akenuLegend/DroneV2/main/gitcode.odt

### Bước 1: Cập nhật tình hình (Pull)

Trước khi bạn định sửa gì, hãy lấy code mới nhất mà đồng đội đã đưa lên về máy mình:

- Chuyển về nhánh chính: git checkout main
- Kéo code mới nhất: git pull origin main

### Bước 2: Tạo "vùng an toàn" (Branch)

Đừng bao giờ sửa code trực tiếp trên nhánh main. Hãy tạo một nhánh riêng cho mình:

- git checkout -b feature-ten-cua-bạn / git checkout branch_cua_minh
- git merge main
  (Lệnh này giúp bạn vừa tạo nhánh mới, vừa nhảy sang nhánh đó luôn).

### Bước 3: Code và Lưu (Add & Commit)

Sau khi bạn đã code xong xuôi một tính năng hoặc sửa xong lỗi:

1. Gom các file đã sửa: git add .
2. Dán nhãn cho những thay đổi đó: git commit -m "Mô tả việc bạn vừa làm"
  *(Ví dụ: git commit -m "Sửa lỗi hiển thị nút bấm") *

### Bước 4: Đưa lên GitHub (Push)

Bây giờ bạn đẩy cái nhánh riêng của mình lên Repo chung trên GitHub:

- git push origin feature-ten-cua-bạn

### Bước 5: Xin phép gộp code (Pull Request - PR)

Bước này làm trên giao diện web GitHub:

1. Vào link Repo của nhóm.
2. Bạn sẽ thấy nút màu xanh "Compare & pull request" hiện lên, hãy nhấn vào đó.
3. Viết vài dòng mô tả (nếu cần) và nhấn "Create pull request".
4. Bây giờ chỉ cần chờ "Chủ xị" (Leader) vào nhấn nút Merge là code của bạn sẽ chính thức nằm trong nhánh main.

### Tóm tắt bộ lệnh "Thần chú" cho bạn:

Hành động | Lệnh Git
Cập nhật code mới nhất | git pull origin main
Tạo và sang nhánh mới | git checkout -b [tên_nhánh]
Lưu code đã sửa | git add . sau đó git commit -m "nhắn gửi"
Đẩy code lên GitHub | git push origin [tên_nhánh]

Lưu ý cực kỳ quan trọng: Nếu bạn gõ git push mà bị báo lỗi, khả năng cao là bạn chưa nhấn "Accept Invitation" trong email mời tham gia Collaborator mà bạn mình gửi đâu. Check mail ngay nếu bị kẹt nhé!

Bạn đã sẵn sàng tạo nhánh đầu tiên chưa? Thử đặt tên nhánh là dev-nguyen-anh-tuan xem sao!

Cách clone về:

git clone <đường-dẫn-vừa-copy>
