akenuLegend/DroneV2/main/sodo.png

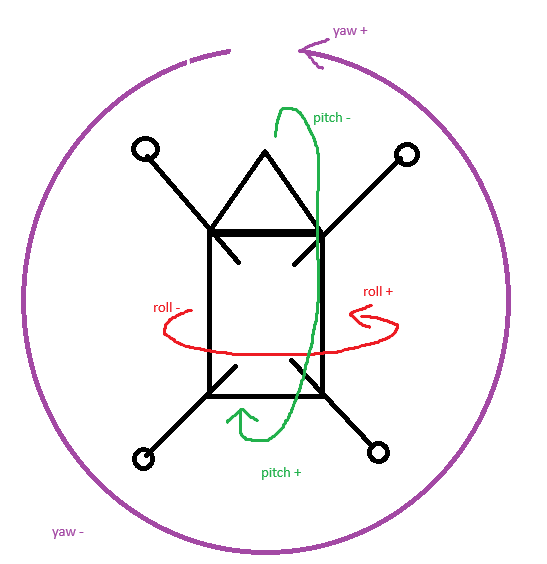
main/sodo.png
