akenuLegend/DroneV2/testZone/drone_alt_hold_1m/docs/PARAMETER_HANDBOOK.md

# Parameter handbook — configuration `0xA41F1001`

## 1. How to use this handbook

This handbook describes the authoritative current values in
`drone_alt_hold_1m.ino` (`FC`) and `sender_1m/sender_1m.ino` (`TX`). Line
locations are approximate and the symbol name is authoritative. Values are
software configuration, not proof of installed-airframe suitability.

Every row provides the requested fields. The section and “Subsystem / meaning”
column identify the subsystem. “Increase / high” and “Decrease / low” combine
directional effect with symptoms when excessive. “Safe direction / step” is a
test recommendation, not permission to fly. “Hold” means there is no evidence-
based numeric change; first collect the named observations using
`TEST_PLAN.md`. Change one parameter family at a time, assign a new config
signature, and retain an old/new/unit/reason/risk/rollback ledger.

Telemetry names below refer either to the sender `STATUS` subset or to fields
carried by telemetry v5. The current sender prints `cfg`, mode/phase/reason,
`z/sp/vz/src/corr`, altitude velocity setpoint/integral, pitch/roll, motor and
hover values, flow/position values, ages/quality/strength, loop/dt/overruns and
MTF/BMP/task diagnostics. The packet also carries yaw/rates, controller outputs,
attitude I terms, biases, vibration/clip and radio counters, but `STATUS` does
not print them. Any row that needs those fields requires a traceable packet
decoder or diagnostic build as a prerequisite. The 248-byte packet itself does
not expose raw sensor innovations, per-axis saturation causes, battery, RPM, or
stack margin; those observations are explicitly marked unavailable.

## 2. Motors and ESC

| Parameter (current value) | Unit; source / location | Subsystem / meaning | Increase / symptoms too high | Decrease / symptoms too low | Safe direction / recommended step | Observe |
|---|---|---|---|---|---|---|
| `IDLE_THROTTLE=1000` | us; FC `:115` | ESC idle/disarmed command and final ramp endpoint. | Can spin motors while nominally safe and reduce shutdown margin. | Below valid ESC pulse may stop arming or be interpreted unpredictably. | Hold; verify against ESC documentation props-off. Do not tune in flight. | Four motors, mode/phase, oscilloscope/logic analyzer (external). |
| `MOTOR_MIN_US=1050` | us; FC `:119` | Minimum armed/mixed command and touchdown intermediate floor. | More residual thrust, bounce, heat, and reduced downward authority. | Motor desync/stall and loss of attitude authority. | Establish the lowest reliable synchronized speed on a guarded rig; if needed change by at most 5 us per build. | M1--M4, throttle, phase; RPM/current are unavailable. |
| `ESC_MIN_US/ESC_MAX_US=1000/2000` | us; FC `:43` | Absolute LEDC conversion range and hardware endpoint assumptions. | Wider upper endpoint can overdrive an ESC/motor if calibration differs. | Narrower range removes available authority. | Hold unless ESC calibration is measured; change only with props removed/guarded stand. | PWM pulse measurement, M1--M4; thrust/current external. |
| `ESC_PIN_M1=26`, `ESC_PIN_M2=13`, `ESC_PIN_M3=14`, `ESC_PIN_M4=27`; `ESC_CH_M1=0`, `ESC_CH_M2=1`, `ESC_CH_M3=2`, `ESC_CH_M4=3` | GPIO, LEDC channel; FC `:40-41` | Physical FL/FR/BR/BL output mapping and single-writer LEDC channel assignment. | Not numeric tuning; any wrong pin/channel moves the wrong motor. | Same. | Mandatory props-off continuity/order/direction test; change only to match verified wiring. | One output at a time, physical motor label/direction and logic-analyzer pulse. |
| `HOVER_DEFAULT=1430` | us; FC `:118` | Boot vertical feed-forward. It is only a plausible estimate between observed lift near 1400 and strong climb near 1500. | Persistent climb/negative PI, early lift, less upper correction headroom. | Persistent sink/positive PI, delayed/no lift, saturation. | After motor/estimator validation use `HOVER n` while DISARMED; steps <=5 us, one short restrained segment each. | `hover`, `hoverTarget`, throttle, `z/vz`, `corr`, `ALTCTL I`, motors. |
| `HOVER_MIN_ALLOWED/HOVER_MAX_ALLOWED=1050/1750` | us; FC `:120-121` | Validation bounds for the RAM hover command. | Raising upper bound permits hazardous feed-forward and shrinks mixer room. | Raising lower bound can prevent a valid light-frame value; lowering permits non-hover values. | Hold; these are safety validation bounds, not tuning targets. | Command rejection, hover fields, motors. |
| `HOVER_SLEW_US_PER_S=100` | us/s; FC `:125` | Slews a hover-setting change accepted while DISARMED; the slew continues on subsequent control ticks. | Faster application can step collective after configuration changes. | Slower application delays convergence and confounds short tests. | Hold; wait for `hover==hoverTarget` before ARM. If measured response requires change, <=10% per props-off/restrained build. | `hover/hoverTarget`, throttle, `dt`. |
| Sender local `hoverUs=1400` | us; TX `:94` | Initial command-payload placeholder; it does not change the drone's `HOVER_DEFAULT=1430` on boot or heartbeat. An explicit valid `HOVER n`/`5 n` replaces it before `CMD_SET_HOVER`. | Not a flight gain until explicitly sent; a larger sent value raises feed-forward. | A smaller sent value lowers feed-forward. | Always issue and verify an explicit intended value while DISARMED; do not infer the drone value from this TX initializer. | Drone `hover/hoverTarget`, command acknowledgement and config identity. |
| `ESC_PWM_HZ=200`, `ESC_PWM_BITS=16` | Hz, bits; FC `:42` | LEDC carrier and duty resolution. Physical updates occur on PWM boundaries. | Higher rate may violate ESC protocol/timing; resolution tradeoff changes. | Lower rate adds command latency/ripple. | Hold until ESC documentation and pulse capture support a change; never tune by flight feel alone. | Logic analyzer; command loop/dt; RPM external. |
| `TRIM_M1/TRIM_M2/TRIM_M3/TRIM_M4=0/0/0/0` | us; FC trim constants | Static per-motor PWM offsets after mixing. | Positive trim creates persistent corner thrust and saturation. | Negative trim creates weak corner/desync risk. | Hold at zero; use measured thrust matching only, not CG compensation. | M1--M4, pitch/roll, controller outputs; thrust/RPM external. |
| `THRUST_EXPO=0.0` | ratio; FC `:323` | Disables inverse quadratic thrust linearization. | More compensation can improve linearity only with a measured curve; wrong expo distorts collective/authority. | Toward zero restores direct PWM behavior but leaves plant nonlinearity. | Hold until all four thrust curves are measured; then fit, replay, and introduce <=0.05 per build. | Requested/applied motors; thrust/current/RPM external and currently absent. |

## 3. Mixer and actuator authority

| Parameter (current value) | Unit; source / location | Subsystem / meaning | Increase / symptoms too high | Decrease / symptoms too low | Safe direction / recommended step | Observe |
|---|---|---|---|---|---|---|
| `THROTTLE_BAND_PCT=0.25`, `THROTTLE_BAND_MIN=60`, `THROTTLE_BAND_MAX=350` | ratio, us; FC `:122-124` | Normal airborne motor-authority band around hover. | More attitude authority/spread but less collective margin; motors pin at bounds. | Weak disturbance rejection and large attitude error. | Do not increase before motor/mixer identification; if justified change percentage <=0.02 and keep hard caps. | M1--M4, throttle, P/R, `outP/R/Y`, integrals; axis saturation unavailable. |
| `MIX_PITCH_SIGN/MIX_ROLL_SIGN/MIX_YAW_SIGN=+1/+1/+1` | sign; FC `:259-261` | Maps controller corrections into the X mixer. | A sign is not a gain; wrong positive sign causes positive feedback. | Wrong negative sign also causes positive feedback. | Props-off/low-energy sign test only; flip exactly one verified wrong axis, never “tune” magnitude. | Hand-induced P/R/yaw rate and expected motor pair changes. |
| `YAW_HEADROOM_PCT=0.20` | ratio of available span; FC `:318` | Minimum yaw range retained before allocating remaining span. | More yaw authority sacrifices pitch/roll/collective sooner. | Yaw saturates/drifts under load. | Prioritize pitch/roll safety; do not increase without saturation traces. Candidate step <=0.02. | `outY`, yaw rate, M1--M4; per-axis limit flag unavailable. |
| `ANGLE_BOOST_ON=1`, `ANGLE_BOOST_COS_MIN=0.5` | boolean, cosine; FC `:326-327` | Compensates vertical thrust loss with tilt; capped at 2x mathematical factor and faded near horizontal. Disabled in ground mixer. | Raising cosine minimum reduces maximum boost; lowering it permits larger collective amplification. | Excessively high minimum under-compensates tilt; excessively low can surge collective. | Hold until thrust/tilt response is measured; test only restrained. If changed, cosine step <=0.05. | throttle versus M1--M4, P/R, z/vz, corr. |
| `TAKEOFF_GROUND_MOTOR_DELTA_US=50` | us above requested base; FC `:153`, ground mixer | Pre-lift cap on any motor, with no upward base shift. | More ground leveling torque but aggressive corner/skid unload. | Less torque; craft may not correct before lift. | Preserve until 0° restrained test passes; then 3°/5°. No numeric change without motor/tilt trace. | Phase, throttle, each motor, P/R/rates, `outP/R/Y`. |
| `CG_PITCH_COMP_US_AT_HOVER=+15`, `CG_ROLL_COMP_US_AT_HOVER=0`, `CG_COMP_MAX_US=30` | us of mixer-axis moment; FC CG constants/`cg*Compensation()` | Feed-forward for the reported forward battery/CG offset. Positive pitch raises M1/M2 and lowers M3/M4. It is zero at 1050 us, ramps with collective, saturates at hover and preserves mean PWM before clamping. | More positive pitch compensation resists nose-down release but can tip/accelerate backward, consume mixer headroom or unload rear motors. | Too little leaves a nose-down transient and forward velocity; negative reverses correction. | Mechanical rebalance first. Restrained 0° test only; change pitch by <=2 us/build, roll separately only with evidence. Never exceed the 30 us guard or tune from free flight. | Startup config, M1+M2 versus M3+M4, P/pitchRate, `outP`, flow forward speed, saturation/thrust/RPM external. |

## 4. Attitude estimator and angle controller

| Parameter (current value) | Unit; source / location | Subsystem / meaning | Increase / symptoms too high | Decrease / symptoms too low | Safe direction / recommended step | Observe |
|---|---|---|---|---|---|---|
| `MPU_MOUNT_Y_FORWARD=1` | axis mapping; FC `:256` | Declares chip +Y as airframe forward and selects pitch/roll transforms. | Not numeric; wrong mapping couples/swaps axes. | Same. | Verify props-off; change only to the physically correct mapping. | P/R signs while tilting one axis; gyro rates. |
| `PITCH_TRIM_DEG=0`, `ROLL_TRIM_DEG=0`, `TRIM_DEG_MAX=5` | deg; FC trim constants | Normal level target and guard. Zero prevents a permanent commanded tilt; CG moment is handled separately by feed-forward. | Nonzero magnitude commands steady tilt/translation and can fight position hold. | Zero is the correct level demand after level calibration. | Keep zero for autonomous position hold; fix sensor mounting/reference instead of introducing angle trim. | P/R, position velocity/drift, controller I, motor spread. |
| `ATT_US_PER_DEG=3.0`; `PITCH_ANGLE_KP=2.0`, `ROLL_ANGLE_KP=2.0` | us/deg and (deg/s)/deg; FC `:284/:289/:294` | Angle slope is derived as `ATT_US_PER_DEG / axis RATE_KP` before sqrt acceleration limiting. | Raising `ATT_US_PER_DEG` or the derived angle gain gives faster correction, overshoot/rate saturation if high. | Lower gain gives sluggish leveling and persistent angle error. | Tune only after rate loop; <=5% one angle-gain family/build and preserve the documented derivation. | P/R target/error (target not directly telemetered), rates, `outP/R`, motors. |
| MPU config `MPU_FREQ=400000`, DLPF `0x03`, gyro/accel `0x08/0x08`, divider `0x00`; `GYRO_SCALE=65.5`, `ACCEL_SCALE=8192` | Hz/registers/LSB; FC `:48`, `mpuInit()`, `:933-934` | I2C rate and fail-closed 1 kHz, +/-500 deg/s, +/-4 g measurement contract. | Faster bus or wider ranges can reduce wiring margin/resolution; mismatched scale corrupts control units. | Slower bus adds latency; narrower ranges can clip. | Not flight tuning. Require exact readback and reference-rate/angle tests; change config and scale together only. | Startup readback, control dt/overruns, clip, external angle/rate reference. |
| `YAW_ANGLE_KP=1.0` | (deg/s)/deg; FC `:299` | Gyro-only yaw-heading error to desired yaw rate. | More aggressive yaw hunting with heading drift. | Weak heading hold/drift. | Hold until gyro bias/yaw drift is characterized; <=5% if justified. | yaw/yawRate, `outY`, iYaw, motors. |
| `MAX_RATE=200`, `MAX_YAW_RATE=160` | deg/s; FC `:301-302` | Caps desired attitude/yaw rates. | Faster/aggressive motion and saturation. | Slower recovery and disturbance rejection. | Do not raise for this autonomous hover mission; reductions <=10 deg/s only if logs show rate saturation is not required for recovery. | P/R/yaw rates, outputs, motors, attitude error. |
| `ANGLE_ACCEL_MAX=200` | deg/s²; FC `:305` | Sqrt-controller angular acceleration bound. | Sharper desired-rate changes, motor steps/overshoot. | Slow recovery and possible large sustained angle error. | After rate loop validation, <=10% per restrained build. | Rates, outputs, motor per-tick changes, P/R. |
| `ANGLE_DEADBAND=0.2` | deg; FC `:315` | Removes tiny pitch/roll error before angle control. | More neutral zone/drift, less chatter. | More noise-driven motor activity. | Use stationary angle-noise distribution; step <=0.05 deg. | P/R noise, outputs, motors, vibration. |
| `MADGWICK_BETA=0.1` | algorithm coefficient; FC `:275` | Accelerometer correction strength for attitude. | Faster gravity correction but vibration/linear acceleration tilts estimate. | More gyro drift and slow leveling. | Hold until raw/filtered vibration and reference-angle data exist; candidate <=10%. | P/R, accel weight `accW`, vib, rates; reference attitude external. |
| `MADGWICK_ZETA=0.05`, `BIAS_LEARN_MAX_RATE=30` | coefficient, deg/s; FC `:276/:314` | Online gyro-bias learning strength and motion gate. | More/faster learning can absorb real motion as bias. | Less learning leaves drift. | Characterize stationary bias/thermal drift first; one coefficient <=10% per props-off dataset. | `biasX/Y/Z`, cal bias, yaw drift, rates, `accW`. |
| `ACC_DEV_FULL=0.06`, `ACC_DEV_ZERO=0.25` | deviation from calibrated g; FC `:279-280` | Full-to-zero accelerometer trust window. | Raising thresholds trusts acceleration/vibration more. | Lowering thresholds relies more on gyro and increases drift. | Derive from restrained vibration distributions; do not widen first. Candidate step <=0.01 g. | `accW`, vibX/Y/Z, clip, P/R. |
| `CLIP_LSB=32000` | raw counts; FC `:281` | Near-full-scale clip diagnostic on accel/gyro. | Higher may miss saturation. | Lower creates false clip/pre-arm blocks. | Hold; sensor full-scale defines this, not flight tuning. | `clip`, raw IMU unavailable. |

## 5. Rate PID

| Parameter (current value) | Unit; source / location | Subsystem / meaning | Increase / symptoms too high | Decrease / symptoms too low | Safe direction / recommended step | Observe |
|---|---|---|---|---|---|---|
| `PITCH_RATE_KP/ROLL_RATE_KP=1.5/1.5` | us/(deg/s); FC `:286/:291` | Proportional body-rate damping. | Oscillation, harsh motor spread, noise amplification. | Sluggish response, poor damping, growing angle error. | Restrained rate-loop identification; one axis at a time, <=5%. | P/R rates, `outP/R`, motor spread, vibration. |
| `PITCH_RATE_KI/ROLL_RATE_KI=0.40/0.40` | us/deg; FC `:287/:292` | Rejects steady torque bias; gated by saturation/phase. | Slow oscillation/windup and persistent motor offset. | Steady rate/angle bias under asymmetric load. | Tune after P; <=0.05 per build and verify unwind. | `iPitch/iRoll`, outputs, motors, saturation behavior. |
| `PITCH_RATE_KD/ROLL_RATE_KD=0.04/0.04` | us/(deg/s²); FC `:288/:293` | Derivative on measured rate. | Motor chatter/heating and vibration feedback. | Less damping/overshoot control. | Require gyro/output spectra; <=0.005 per restrained build. | Rates, outputs, vib/clip; spectra require external capture. |
| `YAW_RATE_KP/YAW_RATE_KI/YAW_RATE_KD=2.50/2.0/0.015` | PID units; FC `:296-298` | Yaw-rate control without compass. | High P/D chatters/saturates; high I winds against drift/imbalance. | Weak yaw hold and slow torque rejection. | Tune only after P/R and motor direction pass; one term <=5%, I last. | yawRate, `outY`, iYaw, motor pairs. |
| `RATE_OUT_LIMIT=120` | us axis correction; FC `:307` | Per-rate-PID output bound, later constrained by mixer. | Larger motor spread/saturation and ground hazard outside special mixer. | Insufficient attitude recovery. | Do not raise before achieved-authority data; reductions <=5 us only if recovery margin remains. | Outputs, motors, P/R/rates; saturation flags unavailable. |
| `RATE_I_LIMIT=30`, `RATE_I_LIMIT_PR=20` | us; FC `:308-309` | Yaw/global init limit and pitch/roll cascaded integral limits. | More stored torque and rebound after saturation. | Less bias rejection. | Keep bounded; if logs prove sustained unsaturated bias, <=2 us/build. | iPitch/iRoll/iYaw, rates, motors. |
| `ITERM_RELAX_DEG=7` (`ITERM_RELAX_RATE=14`) | deg, deg/s; FC `:311-312` | Fades P/R integration as desired rate rises. | Higher keeps I active during maneuvers, increasing windup risk. | Lower suppresses I during smaller corrections. | Hold until desired-rate telemetry exists; <=0.5 deg after replay. | I terms, rates/output; desired rate not directly available. |
| `DTERM_LPF_HZ=25` | Hz; FC `:272` | Filters derivative-on-rate. | Higher bandwidth improves phase but passes vibration/noise. | Lower reduces chatter but adds lag. | Use spectra; <=10% cutoff per guarded test. | Output/motor spectra, vib/clip, rates. |

## 6. Altitude position loop

| Parameter (current value) | Unit; source / location | Subsystem / meaning | Increase / symptoms too high | Decrease / symptoms too low | Safe direction / recommended step | Observe |
|---|---|---|---|---|---|---|
| `MTF_SENSOR_TO_DRONE_BOTTOM_M=0.12` | m; FC `:138` | Converts sensor range to lowest-airframe clearance. | Too large reports low/negative altitude and can delay touchdown logic. | Too small reports excess clearance and changes target/touchdown geometry. | Measure physically; set measured value, not a flight-tuning step. Revalidate all ground gates. | raw range is unavailable; `rangeAltitudeM`, z, ground zero, phase. |
| `ALT_TARGET_M=0.50` | m clearance; FC altitude constants | Autonomous hold target after takeoff. | Higher increases energy, range/flow demands and ceiling margin use. | Lower increases ground effect/touchdown interaction. | This is the requested target. Validate on restrained/netted tests before changing; future commanded targets must remain inside the proven envelope. | z/sp/vz, source/strength/quality, motors. |
| `ALT_SETPOINT_SLEW_MPS=0.12` | m/s; FC altitude constants | Maximum takeoff altitude-target rise after confirmed lift. Reduced from 0.25 for gentle lift. | Faster stored demand/climb/overshoot. | Slower climb; may reach takeoff timeout. | Hold for first restrained traces; if response is stable and unsaturated, <=0.01 m/s/build. | z/sp/vz, phase, corr/I, motors. |
| `ALT_POS_KP=0.70` | (m/s)/m; FC `:166` | Altitude error to vertical-velocity target. | Aggressive velocity demand, overshoot and limit cycling. | Slow height recovery/droop. | Tune after estimator/feed-forward; <=5% per netted run. | z-sp error, `ALTCTL vsp`, vz, corr/I. |
| `ALT_POS_DEADBAND_M=0.015` | m; FC `:167` | Removes small altitude error. | Loose height band and drift. | Noise-driven velocity commands. | Set from stationary fused-height noise; <=0.005 m step. | z/sp/vsp, source ages, correction. |
| `ALT_HOLD_TOLERANCE_M=0.08` | m; FC `:178` | Height part of 0.6 s TAKEOFF-to-HOLD capture test. | Earlier/wider capture despite residual error. | Delayed/no capture and timeout. | Hold until current takeoff trace; <=0.01 m only with predeclared capture criterion. | mode/phase, z/sp/vz. |
| `ALT_MAX_M=1.60` | m; FC `:179` | Ceiling that starts controlled failsafe landing. | Higher permits more energy/space before safety action. | Lower may false-trigger on overshoot/noise. | Safety limit: do not raise. Lower only to facility constraint after sensor-error study. | z/src/range/baro ages, reason, phase. |

## 7. Vertical-velocity loop and collective shaping

| Parameter (current value) | Unit; source / location | Subsystem / meaning | Increase / symptoms too high | Decrease / symptoms too low | Safe direction / recommended step | Observe |
|---|---|---|---|---|---|---|
| `ALT_VEL_MAX_UP_MPS/ALT_VEL_MAX_DOWN_MPS=0.20/0.12` | m/s; FC vertical constants | Bounds climb and descent targets. Reduced from 0.35/0.20 for gentle transitions. Down is stored as positive magnitude. | Faster motion, overshoot/impact energy. | Sluggish transitions; timeout exposure. | Hold for first restrained traces; <=0.01 m/s one direction/build only after evidence. | vsp, vz, z/sp, phase, correction. |
| `ALT_VEL_ACCEL_UP_MPS2/ALT_VEL_ACCEL_DOWN_MPS2=0.20/0.35` | m/s²; FC vertical constants | Slews vertical-velocity target; reduced from 0.40/0.60. | Sharper throttle transients/overshoot. | Slow braking/response and tracking lag. | Hold for first restrained traces; change one direction <=10% after vsp/vz replay. | vsp, vz, corr, throttle/motors. |
| `ALT_VEL_DEADBAND_MPS=0.025` | m/s; FC `:168` | Removes tiny velocity error before PI. | Persistent small climb/sink accepted. | Noise drives correction/I. | Set from stationary fused-Vz distribution; <=0.005 m/s. | vz/vsp, corr/I, sensor sources. |
| `ALT_VEL_KP_US_PER_MPS=80` | us/(m/s); FC `:173` | Velocity proportional correction. | Vertical oscillation, alternating saturation, harsh braking. | Poor damping/large velocity error. | Tune after estimator delay measurement; <=5 us/(m/s) per netted run. | vz/vsp, corr, throttle, motors, z. |
| `ALT_VEL_KI_US_PER_M=30` | us/m; FC `:174` | Integrates velocity error to compensate hover bias. | Windup/slow yo-yo, correction pinned. | Persistent hover bias/correction error. | Set hover first; then <=3 us/m per run, confirm unwind. | `ALTCTL I`, corr, vz, saturation/motors. |
| `ALT_I_LIMIT_US=40` | us; FC `:175` | Bounds altitude integrator. | More stored demand and rebound. | Cannot compensate feed-forward/load error. | Do not increase to mask wrong hover; <=5 us only with unsaturated steady bias evidence. | I, corr, motors, hover. |
| `ALT_CORRECTION_UP_US/ALT_CORRECTION_DOWN_US=70/45` | us; FC `:176-177` | Asymmetric PI correction authority. | Larger limits increase overshoot/saturation or hard descent. | Smaller limits may not arrest motion/hold load. | Do not widen first. If stand/flight logs justify, <=5 us one side/build. | corr, vz, throttle, motors, mixer saturation evidence. |
| `ALT_THROTTLE_UP_US_PER_S/ALT_THROTTLE_DOWN_US_PER_S=90/100` | us/s; FC vertical constants | Normal-flight collective slew after altitude PI. Up-rate reduced from 180 to prevent post-liftoff surge; down-rate remains 100 for braking. | Faster up response can surge; faster down response can cut lift. | Sluggish arrest/recovery, persistent slew saturation. | Hold for first restrained traces; <=10% one direction/build after demand-versus-achieved evidence. | throttle, corr, `ALTCTL I`, vz, motor steps. |
| Airborne descent floor: at altitude `>=0.40 m`, desired collective `>=HOVER_THROTTLE-35 us` | m, us; FC `altitudeThrottle():3462-3463` | Prevents a deep collective cut above 0.40 m during TAKEOFF/ALT_HOLD. | Larger floor/reaching it lower resists sink but can cause hover/overshoot and reduce descent authority. | Smaller floor permits stronger braking but can produce lift loss/free fall. | Important hard-coded behavior: hold until netted descent/braking evidence; if changed, name it as a constant and use <=5 us or 0.05 m per build. | z/vz/vsp, throttle/corr/I, motors and achieved descent. |

## 8. MTF01P range

| Parameter (current value) | Unit; source / location | Subsystem / meaning | Increase / symptoms too high | Decrease / symptoms too low | Safe direction / recommended step | Observe |
|---|---|---|---|---|---|---|
| `MTF_BAUD=115200`, Micolink message `0x51`, payload `20` | baud/protocol; FC `:57`, parser `:1223` | UART transport contract. | Not a tuning direction; mismatch yields no valid frames. | Same. | Match sensor configuration exactly; props-off verification. | MTF rate/gap, bad/stale, backlog, range age. |
| Status `0x01`, strength `>=10`, distance `30..12000` | code, count, mm; FC `acceptRange():1377` | Hard range acceptance gates. | Raising strength/min range or lowering max rejects more data; opposite admits weaker/out-of-envelope data. | Over-permissive gates can feed bad range; over-strict gates cause fallback/failsafe. | Hold. Build error-versus-strength/range dataset before any one-bound change; no blind threshold step. | strength, range age, source, bad/stale; raw rejection reason unavailable. |
| Parser inter-byte timeout `20 ms`, reboot/backstep recognition `>=5000 ms` | ms; FC `:1199/:1227` | Resets partial frames and recognizes a large sensor-clock restart/wrap. | Longer parser timeout retains corrupt partial frames; larger reboot delta delays recovery. | Shorter timeout drops slow frames; smaller reboot delta may accept clock regressions. | Hold unless UART captures prove a failure; change one bound <=20% in replay first. | MTF bad/stale/rate/gap/backlog. |
| Step gate `150 + 3000*dt + 0.15*range`; candidate agreement `max(80,0.15*range)`; confirm `3` | mm, mm/s, ratio, frames; FC `:1388-1394` | Rejects isolated range steps while allowing repeated new level. | Wider/fewer confirms admits spikes. | Narrower/more confirms delays real motion/step recovery. | Replay reference motion and outliers; change one term <=10%, never all together. | separate raw/filtered range is unavailable; z/range/source/corr and diagnostic stream required. |
| `RANGE_FRESH_MS=250`, `RANGE_FAILSAFE_MS=800` | ms; FC `:191-192` | Eligibility age and TAKEOFF/HOLD controlled-landing trigger. | Longer values reuse stale range longer. | Shorter values cause dropout/failsafe on normal jitter. | Hold until measured gap distribution; safety timeout changes need worst-case dropout evidence, not a nominal step. | range age, MTF rate/max gap/backlog, source, mode/reason. |
| Tilt cosine clamp `0.50..1.0` | ratio; FC `acceptRange():1398` | Limits slant-range correction to at most 2x geometric factor. | Higher minimum under-corrects large tilt. | Lower minimum magnifies range/noise at unsafe tilt. | Hold; mission tilt is small and attitude/range geometry needs reference data. | P/R, range altitude, source/strength. |

## 9. BMP388

| Parameter (current value) | Unit; source / location | Subsystem / meaning | Increase / symptoms too high | Decrease / symptoms too low | Safe direction / recommended step | Observe |
|---|---|---|---|---|---|---|
| Address probe `0x77`, then `0x76`; `AUX_FREQ=400000` | address, Hz; FC `:54`, `beginBmp388()` | Bus identity/rate. | Faster bus may exceed wiring/device margin. | Slower bus increases blocking latency. | Use correct address automatically; hold 400 kHz unless scope/error data requires 100 kHz. | BMP fail/read time/rate, AUX wait/miss, altitude gap. |
| Pressure oversampling `8x`, temperature `none`, IIR coefficient `7`, ODR field `50 Hz` | driver enums; FC `:1825-1828` | BMP conversion/filter configuration; forced reads mean ODR is not measured cadence. | More oversampling/IIR reduces noise but increases delay/conversion time. | Less reduces delay but raises noise. | Collect stationary/motion data; change one setting/build and remeasure read time/rate/noise. | BMP rate/read max, baro altitude/Vz; raw pressure unavailable. |
| Read-attempt spacing `22 ms` | ms; FC `serviceBmp():1505` | Host cap of about 45.5 attempts/s. | Larger spacing lowers rate/CPU load and increases latency. | Smaller may request before conversion completes and block/fail. | Hold until actual successful rate/read duration is logged; candidate step 2 ms on bench only. | BMP rate/read max/fail, altitude gap, MTF backlog. |
| Valid pressure `30000..110000 Pa` | Pa; FC `:1523` | Rejects non-finite/out-of-operating-environment pressure. | Raising minimum/lowering maximum rejects valid altitude/weather. | Widening admits implausible sensor values. | Hold; set only for documented operating environment. | BMP fail, baro age/source; raw pressure unavailable. |
| `BARO_FRESH_MS=250`, AUX wait `2 ms`, AUX I2C timeout `10 ms` | ms; FC `:193/:61`, setup `:2845` | Freshness and bounded bus/resource waits. | Longer freshness/waits can reuse stale data or starve service. | Shorter can drop valid slow reads/mutex access. | Use measured distributions; do not increase AUX wait before timing evidence. Candidate 1 ms only on bench. | baro age, BMP rate/read, AUX wait/miss, altitude gap, control dt. |
| Baro height EMA coefficient `0.08`; velocity history `12`, LPF coefficient `0.10`, raw Vz clamp `±3` | ratio, samples, m/s; FC `:1536-1545` | Local barometer height/velocity smoothing. | Larger coefficients respond faster/noisier; longer history smooths/delays. | Smaller coefficients lag; shorter history raises derivative noise. | Measure step delay/RMS first; one coefficient/history change <=10% per replay. | baro altitude, fused z/vz/source; raw stages unavailable. |

## 10. Sensor fusion

| Parameter (current value) | Unit; source / location | Subsystem / meaning | Increase / symptoms too high | Decrease / symptoms too low | Safe direction / recommended step | Observe |
|---|---|---|---|---|---|---|
| `FUSION_BARO_HEIGHT_WEIGHT=0.10` | ratio; FC `:208` | BMP share when range/barometer agree; MTF share is 0.90. | More barometer influence: smoother/long-term continuity but pressure drift/lag. | More MTF influence: responsive but vulnerable to weak returns. | Hold until separate-sensor innovation/error dataset; candidate <=0.02 in replay. | range/baro/fused altitude, source, strength; innovation unavailable. |
| `FUSION_BARO_VEL_WEIGHT=0.30` | ratio; FC `:209` | BMP share of measured fused vertical velocity. | More barometer delay/noise influence. | More range derivative influence/outlier sensitivity. | Hold; candidate <=0.05 only after group-delay/noise measurement. | fused vz, separate heights, source, correction; separate Vz unavailable. |
| `FUSION_HEIGHT_TAU_MTF_S/FUSION_HEIGHT_TAU_BARO_S=0.12/0.45` | s; FC `:210-211` | Source-dependent fused-height correction time constants. | Larger tau smooths but delays response. | Smaller tau follows noise/steps and can kick throttle. | Change one tau <=10% in replay before restrained test. | z/range/baro, vz/corr, source transitions. |
| `FUSION_VELOCITY_TAU_S=0.18` | s; FC `:212` | Fused velocity correction smoothing. | More braking lag/overshoot. | More noisy correction/throttle chatter. | Highest-priority delay study; step <=0.02 s only after measured motion profile. | vz/corr/throttle, z reference; raw velocities unavailable. |
| `BARO_ALIGN_TAU_S=8`, `BARO_INNOVATION_GATE_M=0.45` | s, m; FC `:213-214` | Slow BMP-to-range offset learning and agreement gate. | Slower/larger gate: stale bias or bad agreement can persist/admit. | Faster/smaller gate: follows transients or rejects valid recovery. | Hold until stationary drift and occlusion/recovery innovation traces; one parameter <=10%. | range/baro difference, source/recovery; offset/innovation unavailable. |
| `ALT_COAST_MS=600` | ms; FC `:194` | Constant-velocity prediction window after both sources stale. | Longer open-loop estimate use. | Earlier NONE and blind-landing behavior. | Safety policy: hold until dropout and vertical-divergence evidence. | ages/source, z/vz, throttle, mode/reason. |
| `ALT_SOURCE_NONE/ALT_SOURCE_MTF/ALT_SOURCE_BARO/ALT_SOURCE_FUSED/ALT_SOURCE_COAST=0/1/2/3/4` | enum codes; FC `:200-204` | Source-state contract used by fusion, failsafes, telemetry and sender decoding. | Not tunable; changing one code without both sketches/tools mislabels state and can break decisions. | Same. | Hold; update producer, consumer, decoder and schema tests atomically if protocol semantics ever change. | `src`, source ages, config/schema identity. |
| Fusion `dt=0.5..50 ms`, velocity clamp `±2 m/s`, coast decay tau `0.35 s`, altitude invariant `-0.30..12 m` | ms, m/s, s, m; FC `:1612-1643`, sanitizer | Numerical bounds, not mission acceptance limits. | Wider bounds admit implausible state/stall propagation. | Tighter bounds may clip real fault/recovery motion. | Do not tune as performance parameters; change only with fault-model and sensor-envelope evidence. | control/sensor dt, source, z/vz, reason. |
| `ALTITUDE_SNAPSHOT_STALE_MS=100`, reader tries `4` | ms, attempts; FC `:196/:1773` | Task-liveness invalidation and bounded lock-free read. | Longer stale threshold hides altitude-task stalls; more retries add bounded CPU work. | Shorter threshold/more limited retries create false invalidation/collisions. | Hold until measured altitude task gap/read collisions; no deadline policy invented. | altitude gap, source/ages; collision counter not telemetered. |

## 11. Filtering and calibration

| Parameter (current value) | Unit; source / location | Subsystem / meaning | Increase / symptoms too high | Decrease / symptoms too low | Safe direction / recommended step | Observe |
|---|---|---|---|---|---|---|
| `GYRO_LPF_HZ/GYRO_YAW_LPF_HZ=30/30`, `ACC_LPF_HZ=20` | Hz; FC `:270-273` | IMU noise/phase filtering (gyro PT2, accel PT1). | Higher cutoff passes vibration/noise and motor chatter. | Lower cutoff adds control/attitude lag. | Require stationary + motor-on spectra; one cutoff <=10%/build. | rates, outputs, vib/clip, control dt; raw spectra external. |
| `LPF_ORDER_1=1`, `LPF_ORDER_2=2`; gyro P/R/yaw use PT2, accel/setpoint/D-term use PT1 | enum/order; FC `LPFOrder`, `setup()`, `pid_init()`, `cascaded_init()` | Selects one- versus two-pole filtering independently from cutoff. | Raising order at the same cutoff attenuates more noise but adds phase delay. | Lower order reduces delay but passes more noise. | Do not change order and cutoff together; compare spectra and step delay in replay/guarded tests. | Rates/outputs/motors, vibration and external high-rate trace. |
| `SETPOINT_LPF_HZ=20` | Hz; FC `:274` | Smooths angle targets; Task 4 presets it at takeoff capture. | Higher is sharper/more aggressive. | Lower delays leveling/disturbance response. | Hold through initial Task 4 validation; <=10% only after target/response logging. | P/R/rates/motors; filtered setpoint unavailable. |
| Range median `5`, `RANGE_FILTER_TAU_S=0.10` | samples, s; FC `Median5`, `:206` | Robust range smoothing before velocity/fusion. | Larger window/tau adds delay. | Smaller passes spikes/noise. | Measure raw-to-filtered step; tau <=0.01 s or window one odd size per replay. | z/range/vz/corr; raw range unavailable in telemetry. |
| `RANGE_VELOCITY_SAMPLES=15`, `RANGE_VELOCITY_TAU_S=0.20` | samples, s; FC `:205/:207` | Timestamped regression and velocity low-pass. | More samples/tau increases braking delay. | Fewer/smaller tau raises derivative noise. | Do not change both together; one sample or 0.02 s after reference-motion dataset. | z/vz/corr, MTF rate/gap; raw regression unavailable. |
| `ENABLE_AUTO_CALIB=1`; `CAL_BATCH=100`, `CAL_MAX_BATCH=40`, `CAL_CONVERGE_DPS=0.15`, `CAL_ACC_MOVE_G=0.02` | boolean/samples/batches/deg/s/g; FC `:20/:330-333` | Enables boot calibration and defines two-batch stationary convergence. | Looser thresholds false-calibrate motion; more batches delays failure. | Tighter thresholds cause false failure on noise. | Keep auto calibration enabled; characterize stationary distributions props-off/motor-off. No flight tuning. | startup calibration logs, cal bias/offset, vib/clip. |
| Altitude calibration window `1..4 s`, range `>=100`, BMP `>=50`, range sigma `<=0.03 m`, flow `>=50` | time/samples/m; FC `poll():1686-1718` | Ground zero/noise eligibility before arm. | Looser sigma/counts admit unstable zero; tighter/greater counts increase boot failure. | Same tradeoff inversely. | Hold until repeated ground datasets; set limits from distribution with margin. | startup CAL logs, source/ages, strength/quality; sample traces external. |

## 12. Horizontal position hold and optical flow

| Parameter (current value) | Unit; source / location | Subsystem / meaning | Increase / symptoms too high | Decrease / symptoms too low | Safe direction / recommended step | Observe |
|---|---|---|---|---|---|---|
| `FLOW_SWAP_XY=0`, `FLOW_X_SIGN/FLOW_Y_SIGN=+1/+1`; `POS_HOLD_PITCH_SIGN/POS_HOLD_ROLL_SIGN=-1/+1` | mapping/sign; FC `:219-221/:244-245` | Sensor-to-body axes and body-velocity-to-corrective-angle signs. | Not gains; any wrong mapping/sign creates cross-axis or positive feedback. | Same. | Mandatory props-off translation/sign test; change one mapping/sign only when proven. | flow forward/right while moving frame; commanded P/R and motor response. |
| `FLOW_GOOD_STATUS=0x01`, `FLOW_MIN_QUALITY=40`, `FLOW_MIN_HEIGHT_MM=50`, `FLOW_FRESH_MS=250` | code/count/mm/ms; FC `:222-225` | Flow eligibility gates. | Raising quality/height or shortening age disables hold more often; relaxing admits weak/stale flow. | Overly permissive values cause drift/oscillation; overly strict values lose hold. | Do not lower. Build error-versus-quality/height/surface data; adjust one gate only after replay. | FLOW flag, q/age, range age, velocity/position/tilt. |
| `FLOW_FILTER_TAU_S=0.12` | s; FC `:226` | EMA after median/bias removal. | More lag and pendulum tendency. | More noisy tilt demand. | Reference-translation test; <=0.01 s/build after spectra/delay analysis. | flow velocity, position/tilt, P/R, motors. |
| `FLOW_REFERENCE_HEIGHT_M=1.0`, `FLOW_CM_S_TO_M_S=0.01`; scale before median/EMA | m, conversion; FC flow constants/`acceptFlow()` | Converts each synchronized raw flow/range sample from `cm/s @ 1 m` to m/s before filter state is updated. | Reference value is a sensor-unit contract, not a tuning gain; changing it rescales all horizontal velocity. | Same. | Do not tune. Verify against measured translations at every intended height. | raw flow in diagnostic build, range, filtered m/s, independent velocity. |
| `FLOW_DEADBAND_MPS=0.015`, `FLOW_ZERO_SIGMA_MULTIPLIER=3`, `FLOW_MAX_DEADBAND_MPS=0.12` | m/s, ratio; FC flow constants/`acceptFlow()` | Adaptive zero-motion deadband in SI units after per-sample height scale. | Larger values ignore real slow drift. | Smaller values chase optical noise. | Derive from stationary surface datasets; base <=0.005 m/s or multiplier <=0.5 per replay. | flow velocities, q/age, integrated position, tilt. |
| `FLOW_MAX_SPEED_MPS=3.0` | m/s; FC `:230` | Rejects non-finite/implausible processed flow. | Higher admits outliers. | Lower rejects real fast motion and drops hold. | Safety gate: do not raise without calibrated speed envelope. | flow flag/velocity/age, position reset, P/R. |
| `POS_HOLD_FLOW_CONFIRM_S=0.20`, `POS_HOLD_MIN_ALT_M=0.10` | s, m; FC `:233/:242` | Requires sustained eligible flow and clearance before lock. | Longer/higher delays hold and drift capture. | Shorter/lower allows noisy ground-effect lock. | Hold through initial tests; do not reduce first. Candidate +0.05 s is safer if false lock is observed. | phase, z, FLOW flag/age/q, position/tilt. |
| `POS_HOLD_KP_PER_S=0.40`, `POS_HOLD_MAX_VEL_MPS=0.35` | 1/s, m/s; FC position constants/`updatePositionHold()` | Converts signed metric position error from the calibration origin directly to return velocity, then limits the velocity vector magnitude. Horizontal target is exactly `(0,0)`; there is no intentional 0.50 m deadband or acceptance radius. | Larger gain/cap drives pendulum and tilt saturation. | Smaller gain allows more drift and slower return. | Validate velocity damping first; then position gain <=5% per traceable build. Do not raise max velocity first. | radial/axis position, desired/flow velocity, tilt, P/R, motors. |
| `POS_HOLD_VEL_KP_DEG_PER_MPS=3.0`, `POS_HOLD_VEL_KI_DEG_PER_M=0.3`, `POS_HOLD_I_LIMIT_DEG=1.5` | deg/(m/s), deg/m, deg; FC `:236-238` | Flow velocity error to corrective pitch/roll. | High P oscillates; high I winds/drifts; high limit stores lateral demand. | Low gains fail to brake drift/bias. | Validate signs; tune P <=5%, then I <=0.05, one axis/term at a time. | flow velocity, position, tilt commands, P/R, motor saturation. |
| `POS_HOLD_MAX_TILT_DEG=3.5`, `POS_HOLD_TILT_SLEW_DEG_PER_S=8` | deg, deg/s; FC `:239-240` | Caps and slews horizontal attitude demand. | More/faster tilt raises lateral acceleration and altitude/mixer coupling. | Less/slower tilt cannot arrest drift. | Do not raise during first validation; if stable, <=0.25 deg or 1 deg/s per build. | position tilt, actual P/R, z/vz, motors. |
| Calibration-origin position; no position leak; `POS_HOLD_ESTIMATE_LIMIT_M=2.0` radial | m; FC horizontal state/odometry | Keeps one origin for the powered session; 2 m is only a direction-preserving numerical guard. | Reintroducing leak/relock hides accumulated error but violates the fixed-origin contract; increasing guard admits larger numeric state. | A smaller guard clips real estimate earlier; no leak exposes sensor/yaw drift. | Do not add leak to make logs look better. Measure stationary and closed-path drift, then improve sensing/estimation. | position axes/radius, yaw, flow loss/recovery, independent position. |
| ARM/TAKEOFF position admission: fresh flow plus initialized, finite calibration-origin estimate | boolean; FC `armConditionsMet()`/TAKEOFF handler | Prevents intentional position-hold flight without a usable horizontal reference. It does not declare a numeric horizontal accuracy threshold. | Relaxing freshness/validity gates admits stale or invalid feedback. | Stricter gates reject more otherwise usable starts. | Do not relax from flight convenience. Reposition at the calibration origin or reboot/recalibrate if the reference is invalid. | flow flag/age/quality, position axes/radius, rejection reason. |
| Flow-confidence formula `0.40 + (quality-40)/50`, clamp `0.35..1`, full at `70` | ratio; FC `updatePositionHold():3192-3194` | Scales lateral authority for accepted quality. | More baseline/steeper mapping gives weak frames stronger control. | Less authority allows drift but reduces weak-flow excursions. | Current map is unvalidated. Do not increase; derive quality-to-error curve and replay candidate maps. | q, flow velocity, position/tilt, P/R, motor limits. |
| Flow-loss grace `0.35 s`; recovery confirmation `0.20 s` | s; FC `updatePositionHold()` | Retains braking briefly, then removes controller demand while freezing the calibration-origin estimate; recovery returns to the same origin after confirmation. | Longer grace retains stale lateral demand. | Shorter grace drops braking sooner; longer confirmation permits more uncontrolled drift. | Hold; replay good->lost->recovered flow including known displacement during loss. | FLOW flag/age, position/radius, tilt, P/R, recovery step. |

## 13. Takeoff

| Parameter (current value) | Unit; source / location | Subsystem / meaning | Increase / symptoms too high | Decrease / symptoms too low | Safe direction / recommended step | Observe |
|---|---|---|---|---|---|---|
| `SPOOL_UP_S=0.4` | s; FC `:131` | ARMED_IDLE transition from 1000 to 1050 us. | Longer delays readiness; too short from decrease causes command edge. | Shorter/faster spool can jerk/desync. | Hold; verify PWM trace props-off. Candidate +0.1 s is safer if edge observed. | mode, throttle, motors, time. |
| `TAKEOFF_START_US=1350` | us; FC `:142` | Phase boundary between SPOOL_UP and ground lift search; not an airborne/hover claim. | Higher postpones ground monitoring phase. | Lower enters ground phase earlier and starts its 4 s no-lift clock. | Hold; do not tune as lift threshold. | phase, throttle, actual liftoff point. |
| `TAKEOFF_RAMP_US_PER_S=40` | us/s; FC `:143` | Continuous base ramp from actual ARMED_IDLE output to hover. | Faster ramp/aggressive release and less observation time. | Slower takeoff and timeout risk. | Verify 0° first; <=5 us/s only with restrained evidence. | phase, throttle, each motor, z/vz, time. |
| `TAKEOFF_LIFTOFF_M=0.06` or (`0.025 m` and `TAKEOFF_LIFTOFF_VZ_MPS=0.10`), `TAKEOFF_LIFTOFF_CONFIRM_S=0.15` | m, m/s, s; FC `:144-146`, `altitudeThrottle()` | Sustained ground-to-air transition gate; 0.025 m is an in-function secondary clearance. | Higher/longer delays closed loop after true lift. | Lower/shorter accepts noise/ground motion and enables stored demand. | Do not reduce. Validate injected transients props-off and current estimator on restrained rig. | z/vz/source, phase, throttle, I/corr. |
| `TAKEOFF_GROUND_MAX_TILT_DEG=8`; `TAKEOFF_GROUND_ABORT_ANGLE_DEG=12`, `TAKEOFF_GROUND_ABORT_RATE_DPS=45`, `TAKEOFF_GROUND_ABORT_CONFIRM_S=0.10` | deg, deg/s, s; FC `:148-151` | Bounds mild tilted launch and sustained pre-lift divergence. | Raising admission/abort permits more dangerous ground torque/tip. | Lower values reject/abort benign tilt/vibration. | Never raise before 0/3/5 deg staged data. Change one bound only with measured false-abort/safety evidence. | phase/reason, P/R/rates, motors, vib. |
| `TAKEOFF_LEVEL_SLEW_DEG_PER_S=3` | deg/s; FC `:152` | Moves captured ground attitude target toward trim. | Faster corner unload/ground motor demand. | Slower leveling; lift may occur tilted. | Hold; <=0.5 deg/s after 0°/3° target trace. | P/R, phase, outputs/motors; target not telemetered directly. |
| `TAKEOFF_ATTITUDE_TRANSFER_S=0.50` | s; FC `:154` | Per-motor crossfade from ground-limited to normal mixer; I remains gated. | Longer weakens disturbance rejection after lift. | Shorter increases motor step/handover shock. | Hold; candidate +0.1 s is safer if discontinuity, decrease only after authority evidence. | phase, P/R/rates, I terms, M1--M4. |
| `TAKEOFF_NO_RISE_S=4`, `TAKEOFF_TIMEOUT_S=20` | s; FC takeoff constants | Phase-local no-lift abort and total takeoff bound. Total timeout increased from 15 s only to accommodate the slower post-lift trajectory; the 4 s powered no-rise exposure is unchanged. | Longer total timeout extends an airborne transition fault; longer no-rise holds elevated ground throttle. | Shorter total timeout can abort the deliberate gentle ascent; shorter no-rise can reject an underpowered craft. | Keep no-rise at 4 s. The 20 s total bound must contain the measured transition with margin; do not increase again without timing evidence. | phase/time, z/vz, throttle, reason, motor ramp. |
| Clearance/fall gate `0.20/0.15 m`; HOLD capture `abs(Vz)<0.15 m/s` for `0.60 s` | m, m/s, s; FC `altitudeThrottle():3376-3392` | Records genuine climb, detects a subsequent fall, and requires stable altitude/Vz before ALT_HOLD. | Raising clearance or tightening/lengthening capture delays HOLD; lowering the fall gate delays abort. | Lower clearance or looser/shorter capture can accept noise/transient flight; raising the fall gate can false-abort. | Important hard-coded behavior: hold until netted traces; name as constants before one-bound-at-a-time changes. | phase/mode/reason, z/sp/vz/source, throttle/corr/I. |

## 14. Landing

| Parameter (current value) | Unit; source / location | Subsystem / meaning | Increase / symptoms too high | Decrease / symptoms too low | Safe direction / recommended step | Observe |
|---|---|---|---|---|---|---|
| `ALT_LAND_SLEW_MPS=0.08`, `ALT_LAND_NEAR_SLEW_MPS=0.04`, `LAND_NEAR_GROUND_M=0.40` | m/s, m; FC landing constants | Landing altitude-target descent profile, reduced from 0.12/0.05 m/s for a gentler approach. | Faster rates/higher boundary choice can increase impact or extend slow segment depending parameter. | Slower rates prolong landing/timeout and exposure. | Hold for first restrained traces; one rate <=0.01 m/s or boundary <=0.05 m/build. | phase, z/sp/vz, corr/I, throttle. |
| `LAND_THROTTLE_UP_US_PER_S/LAND_THROTTLE_DOWN_US_PER_S=55/50`; `LAND_NEAR_THROTTLE_DOWN_US_PER_S=35` | us/s; FC landing constants | Bumpless vertical correction slew while landing. Down-rates reduced from 70/50; the up-rate is retained so the controller can still arrest an excessive sink. | Faster up can rebound; faster down can drop. | Too slow cannot brake or descend before timeout. | Do not raise down-rate first; <=5 us/s one direction/build after trace. | throttle/corr, z/vz/sp, motors, phase. |
| `LAND_THROTTLE_HEADROOM_US=50`, `LAND_THROTTLE_MAX_US=1470` | us; FC `:163-164` | Landing collective cap `min(hover+50,1470)`. | More cap/headroom permits post-impact/rebound energy. | Less may not arrest a bounded descent. | Do not increase without guarded descent evidence; reductions <=5 us if bounce remains and braking margin exists. | throttle, motors, vz, corr, phase. |
| `ALT_LANDED_M=0.10`, `ALT_LANDED_VZ_MPS=0.25`, `ALT_LANDED_CONFIRM_S=0.40` | m, m/s, s; FC `:180-182` | Fresh-MTF touchdown latch and stable confirmation. | Higher clearance/Vz or shorter confirm causes premature touchdown acceptance. | Lower/tighter/longer delays shutdown and may hit timeout. | Do not loosen. Validate surfaces; one bound <=10% only after false-positive/negative table. | range/z/vz/age, phase, motors. |
| `LAND_TOUCHDOWN_DOWN_US_PER_S=250`, `LAND_TOUCHDOWN_TIMEOUT_S=2.0` | us/s, s; FC `:183-184` | Monotonic per-motor decay toward 1050 after latch and bound to final ramp. | Faster decay/shorter timeout removes authority abruptly. | Slower/longer leaves thrust after contact. | Hold until guarded floor approach; <=25 us/s or 0.2 s/build. | phase, each motor, z/vz/range age. |
| `LAND_MOTOR_RAMP_S=1.0` | s; FC `:185` | Final per-motor interpolation to 1000 and DISARM. | Longer retains powered motors. | Shorter makes sharper shutdown. | Hold; props-off and guarded contact validation. Candidate +0.2 s only if ESC behavior requires. | phase, motors, final mode/time. |
| `BLIND_THROTTLE_DOWN_US_PER_S=25`, `BLIND_LAND_MS=8000` | us/s, ms; FC `:165/:195` | Open-loop descent then TRIPPED when all altitude sources are lost during landing. | Faster/longer: faster drop or longer open-loop exposure. | Slower/shorter: may retain thrust or trip before descent. | Safety fallback is unvalidated; do not tune in free flight. Exercise only model/guarded low-energy setup. | source/ages, throttle/motors, phase/reason, time. |
| `LAND_TIMEOUT_S=24` | s; FC landing constants | Overall landing bound, increased from 18 s to contain the slower 0.08/0.04 m/s profile and preserved across repeated LAND/FAILSAFE. | Longer permits prolonged powered fault. | Shorter may trip during the intentionally slow near-ground descent. | Model gives about 10.15 s nominal from 0.50 m through confirmation/ramp; require measured margin and do not increase again without evidence. | landing start-to-phase times, reason, z/vz, motors. |

## 15. Task frequencies, buses, and communication

| Parameter (current value) | Unit; source / location | Subsystem / meaning | Increase / symptoms too high | Decrease / symptoms too low | Safe direction / recommended step | Observe |
|---|---|---|---|---|---|---|
| `CONTROL_HZ=250`, `IMU_OVERSAMPLE=4`, `SAMPLE_HZ=1000`, `SAMPLE_US=1000` | Hz, samples, us; FC `:107-110` | Busy scheduled MPU acquisition and control after four samples. | Higher rates increase I2C/CPU load and overruns. | Lower rates add control delay/bandwidth loss. | Hold until runtime WCET/jitter and sensor cadence are measured. Never change controller rate without retiming filters/gains. | loopHz, dt/current max, overruns, IMU startup read time. |
| MPU I2C `400 kHz`, timeout `5 ms` | Hz, ms; FC `:48`, setup | Dedicated control-core IMU bus. | Faster rate may violate wiring; longer timeout can hold last motor output longer. | Slower bus/shorter timeout can increase missed samples/trips. | Hold; characterize error/latency with scope and fault injection props-off. | dt/overruns, MPU trip reason; transaction max only startup log. |
| Altitude task core/prio/stack `0/2/6144`, service delay `1 RTOS tick` | core/priority/bytes/time; FC `:58-60/:1816` | Single owner of MTF/BMP/filter/fusion snapshot. | Higher priority/stack uses resources and may contend with radio; lower risks stale altitude. | Same inverse. | Do not change until core timing and stack high-water are measured. | startup core/prio, altitude gap, backlog, BMP/MTF timing; stack unavailable. |
| ESP-NOW task core/prio/stack/queue `0/(max-1)/3072/4` | configuration; FC `:76-79` | Validates command packets off control core. | More queue/stack uses RAM; priority changes can starve altitude or delay KILL. | Smaller resources increase drops/overflow. | Hold; use burst/loss test props-off before resource changes. | rx/bad/lost, link age/state; stack unavailable. |
| `FLIGHT_CONFIG_SIGNATURE=0xA41F1001`; `TELEM_HZ=10`, `TELEM_US=100000`; `TELEM_TASK_CORE=0`, `TELEM_TASK_PRIO=1`, `TELEM_TASK_STACK=3072`; `TELEM_VER=5`, packet 248 B | identifier, Hz/us/config | Build identity and low-priority ESP-NOW status stream. | Higher rate increases radio/core contention and send failures. | Lower rate hides fast transitions. | Increment signature after any firmware parameter/behavior edit. Keep schema/size fixed; use separate logger for high-rate tuning. | Startup and sender cfg, packet version/size, loop/sensor timing and dropped telemetry. |
| `TELEM_SERIAL=0`, `SERIAL_US=100000`; sender `STATUS` at `2 Hz` | boolean, us, Hz; FC `:100/:111`, TX `loop()` | Disables the richer 10 Hz local-drone serial line; sender prints only a subset of packet fields every 500 ms. | Enabling/increasing output adds serial load but improves observability. | Leaving it off avoids control-side serial work but cannot prove rate/output/I-term criteria from sender text alone. | Keep flight build unchanged; use a traceable packet logger/diagnostic build, new signature and Stage A before tests needing omitted fields. | Capture completeness, loop dt/overruns and packet loss. |
| OLED `4 Hz` (`OLED_MS=250`), core0/prio1/stack4096; airborne transfer suppressed | Hz/config; FC display defines/task | Noncritical display on AUX bus. | Higher update can block BMP/core0 more. | Lower is less responsive. | Keep suppressed in flight; no need to tune for control. | AUX wait/miss, BMP rate/read, altitude gap. |
| Radio channel `1`, peer-only/encrypted; TX heartbeat `200 ms`, action repeat `1200 ms`, callback warning `100 ms` | channel/ms; FC `:74-89`, TX `:15-23` | Command authentication/retry/liveness cadence. | Faster traffic increases contention; longer repeat/warning delays new action visibility. | Slower heartbeat approaches link timeout; shorter repeat reduces delivery redundancy. | Hold; RF range/loss test without props. Never shorten safety coverage from one benign run. | drone rx/bad/lost/link, sender txOk/txFail, telemetry continuity. |
| `CMD_HEARTBEAT=0` (idle/default command token) | enum value; FC `CommandType`, TX `CommandType` | Represents no pending action and carries liveness without commanding a mode transition. | Not a tunable magnitude; changing the enum value breaks sender/FC protocol compatibility. | Same. | Do not renumber independently. Any protocol edit requires both endpoints, a new config signature, schema checks and Stage A. | `lastCommand`, mode/phase/reason, rx/bad/lost; `lastCommand` needs packet-level capture. |

## 16. Failsafe and pre-arm

| Parameter (current value) | Unit; source / location | Subsystem / meaning | Increase / symptoms too high | Decrease / symptoms too low | Safe direction / recommended step | Observe |
|---|---|---|---|---|---|---|
| `ARM_MAX_ANGLE=25`, `ARM_MAX_RATE=15`, `LEVEL_OFFSET_MAX=10` | deg, deg/s; FC `:128-133` | General pre-arm level/still/calibration guards; TAKEOFF has stricter 8° admission. | Looser bounds can arm a moving/misreferenced craft. | Tighter bounds cause nuisance rejection. | Do not loosen. Fix surface/calibration/mechanics; any tighter candidate from props-off distributions. | P/R/rates, offset, mode reason. |
| `ARM_CONFIRM_S=2.0`, `ARMED_IDLE_TIMEOUT_MS=15000` | s, ms; FC `:130/:190` | Continuous pre-arm confirmation and auto-disarm waiting for TAKEOFF. | Longer confirm/idle reduces convenience but idle may spin longer. | Short confirm weakens persistence; short idle may nuisance-disarm. | Safety timing: hold; verify exact transitions props-off. | mode/reason, link/sensor ages, motor commands, time. |
| ARM request timeout `10 s`; ground-altitude admission `abs(z)<=0.12 m` | s, m; FC `updateAutoArm():2173`, `armConditionsMet():2142` | Cancels a stale ARM request and prevents arming away from calibrated ground. | Longer/wider limits retain stale intent or admit a raised/mis-zeroed craft. | Shorter/tighter limits cause nuisance cancellation/rejection. | Important hard-coded guards: do not loosen; name as constants before any evidence-backed change. | mode/reason, action time, z/range/baro/source. |
| `ARM_VIB_MAX=0.35`, `ARM_CLIP_MAX=0` | g peak/interval, samples; FC `:252-253` | Blocks arm after vibration or any clipped IMU sample in the telemetry interval. | Higher allowances may arm damaged/vibrating hardware. | Lower vibration threshold creates nuisance blocks. | Do not loosen before motor-off/motor-on vibration distribution. | vibX/Y/Z, clip, reason. |
| `SENSOR_FAIL_LIMIT=50` nominal scheduled reads | reads (~50 ms only if 1 kHz schedule holds); FC `:134` | Consecutive MPU read failures before TRIPPED. | More failures tolerated while old motor commands persist. | Fewer causes trips on transient I2C errors. | Do not convert to a time claim without runtime timing. Hold until injected-fault tests. | dt/max/overruns, mode/reason, motors. |
| `SAFE_ANGLE_ERR=45`, `SAFE_ANGLE_HOLD_S=0.25` | deg setpoint error, s; FC `:248-249` | Sustained airborne pitch/roll control-loss trip. | Larger/longer permits greater divergence. | Smaller/shorter may trip recoverable transients. | Do not loosen; tighter only after bounded response/false-trip data. | P/R, commanded tilt, mode/reason, motors. |
| `TRIP_RAMP_S=1.5` | s; FC `:132` | Normal severe-fault per-motor ramp to 1000; KILL overrides start to idle immediately. | Longer retains thrust during severe fault. | Shorter can abruptly drop/flip airborne craft. | Distinct failure cases need hardware risk analysis; hold. Test KILL only props-off/secured. | reason/mode, each motor, time. |
| `LINK_TIMEOUT_MS=3000` | ms; FC `:81`, TX `:22` | Valid-packet watchdog; disarms ARMED_IDLE or lands TAKEOFF/HOLD. | Longer uncontrolled interval after radio loss. | Shorter false-lands on normal RF gaps. | Hold until packet-gap distribution across intended range; do not raise first. | link, rx/bad/lost, mode/phase/reason. |
| `MAX_FLIGHT_S=60` | s; FC `:188` | Test-session ceiling that starts controlled landing. | Longer battery/thermal/exposure risk without battery telemetry. | Shorter interrupts validation. | Do not increase while battery state is unobserved. | flight time, mode/reason; battery unavailable. |
| `FS_DISARMED=0`; `PHASE_NONE=0` | enum values; FC `FlightMode` / `TransitionPhase` | Safe startup/default mode and absence of an active takeoff/landing sub-phase. | Not tunable; renumbering one endpoint can corrupt telemetry interpretation. | Same. | Do not renumber without synchronized sender decoding, a new config signature and Stage A. | startup and post-disarm mode/phase/reason. |

## 17. Parameters that remain UNKNOWN or unavailable

- Actual CPU frequency, Arduino `loopTask` affinity/priority, task stack
  high-water, WCET/jitter, installed MTF publish latency/rate, BMP conversion
  latency/rate, filter group delay, flow error versus quality/surface/height,
  per-motor thrust/current/RPM, battery sag, frame CG, and current-build flight
  stability are UNKNOWN.
- There is no evidence-based control-deadline trip threshold. `dt` telemetry is
  for measurement; do not turn it into a safety transition until runtime and
  airframe response data justify a policy.
- No handbook recommendation overrides the missing battery failsafe,
  independent hardware kill, ESC feedback, redundant IMU, or persistent log
  gaps in `FINAL_SYSTEM_AUDIT.md`.
- The next action for any “Hold” row is data collection, not a guessed numeric
  edit. Follow `TEST_PLAN.md`, stop at the first failed gate, and keep free
  flight prohibited until all earlier gates have objective evidence.
