akenuLegend/DroneV2/(list of files, drawings)

Other design files:
main/drone.fzz
